tahmidyounus/Smart_Classroom/hardware/UPS_system.jpg

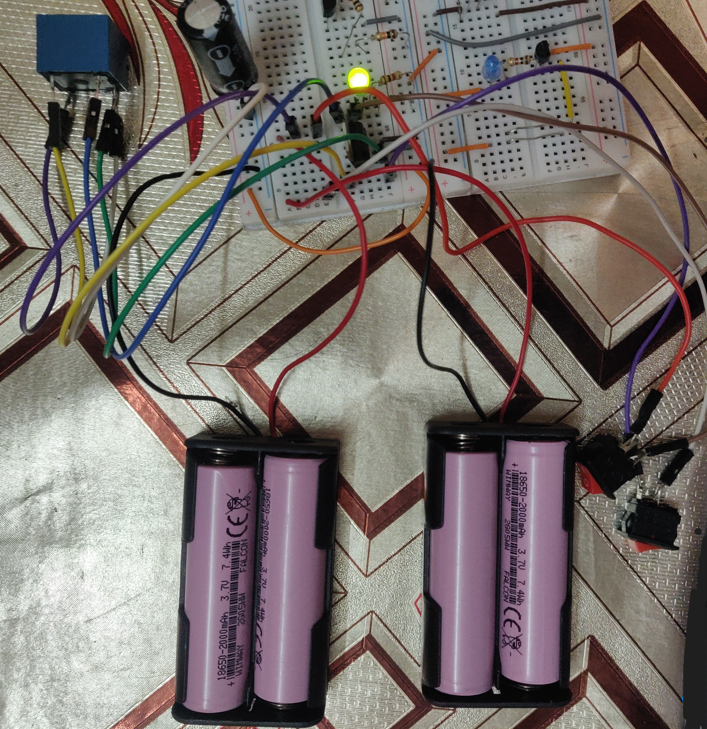
hardware/UPS_system.jpg
