tahmidyounus/Smart_Classroom/hardware/Seats.png

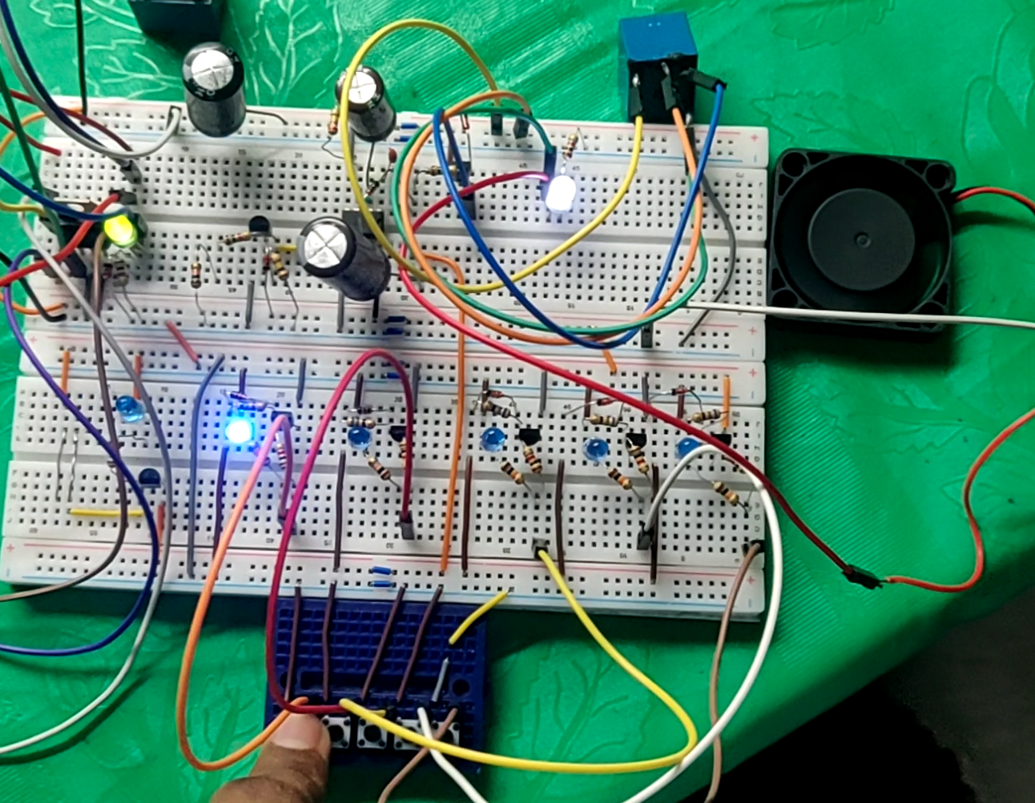
hardware/Seats.png
