tahmidyounus/Smart_Classroom/hardware/Comlete_design.png

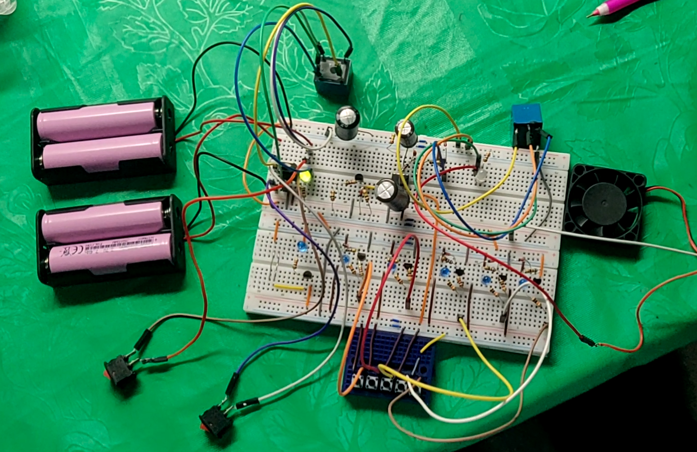
hardware/Comlete_design.png
