tahmidyounus/Smart_Classroom/schematics/Fire_alarm_off.png

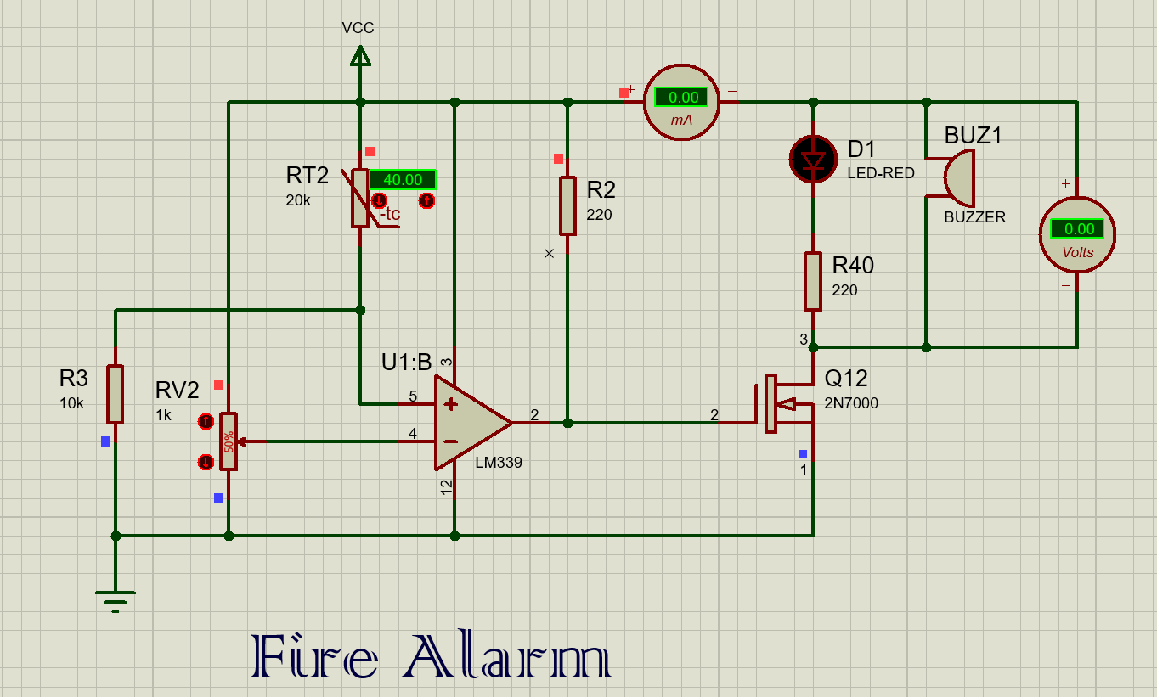
schematics/Fire_alarm_off.png
