tahmidyounus/Smart_Classroom/schematics/Fire_alarm_on.png

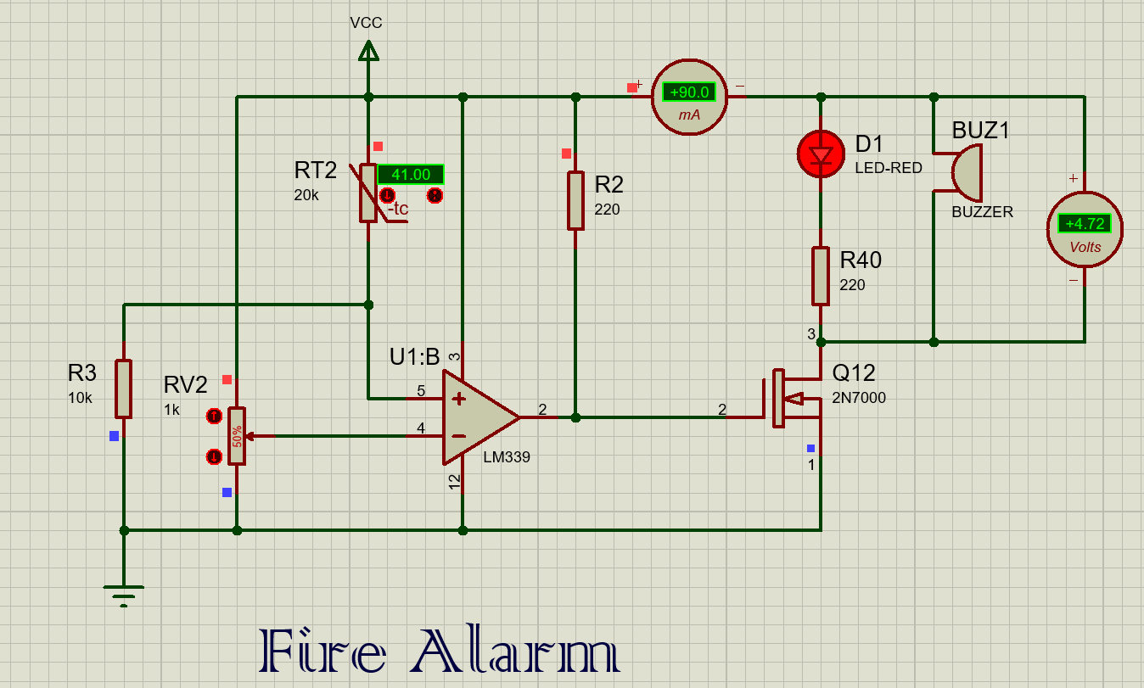
schematics/Fire_alarm_on.png
