tahmidyounus/Smart_Classroom/schematics/output_module.png

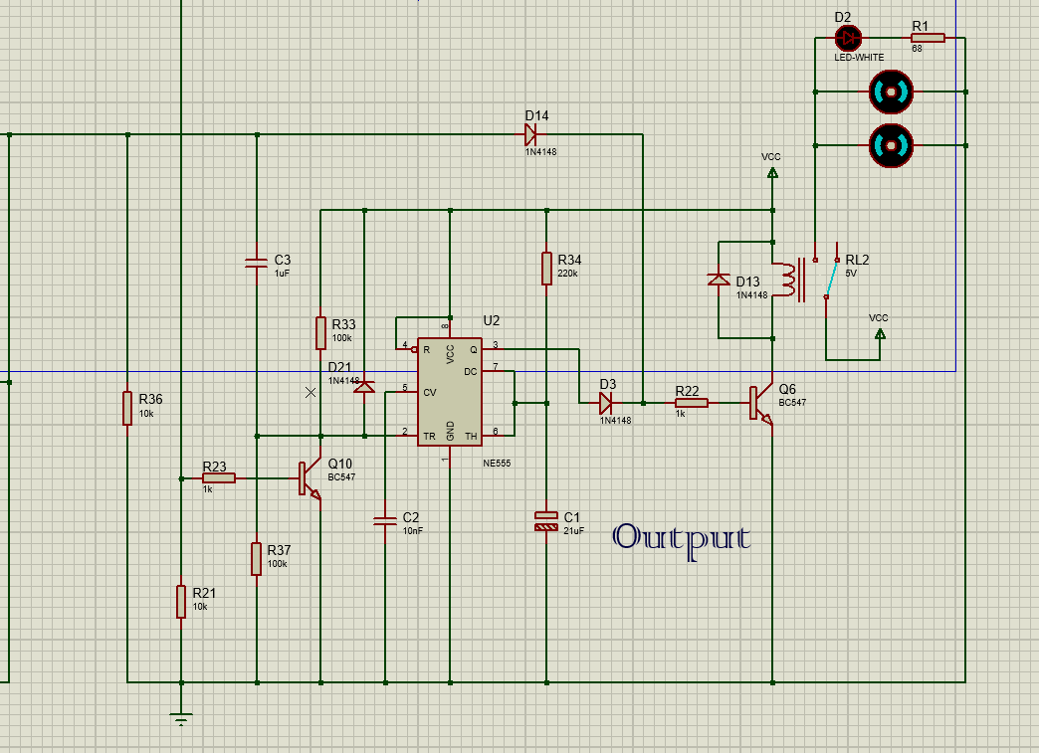
schematics/output_module.png
