tahmidyounus/Smart_Classroom/schematics/Single_seat_turned_on.png

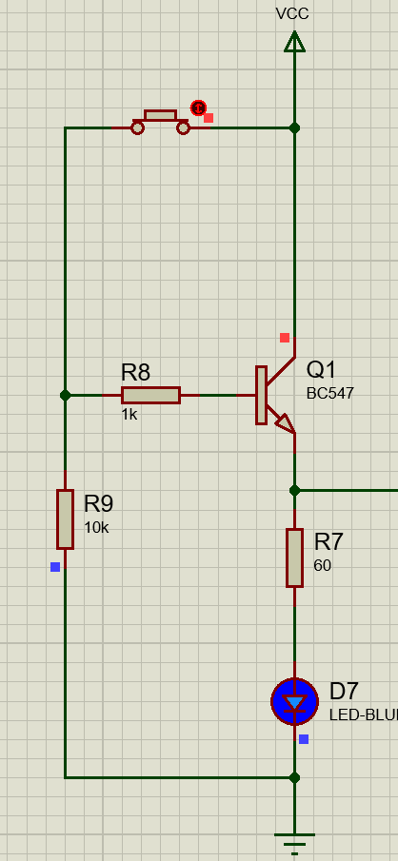
schematics/Single_seat_turned_on.png
