tahmidyounus/Smart_Classroom/schematics/Six_seat_module.png

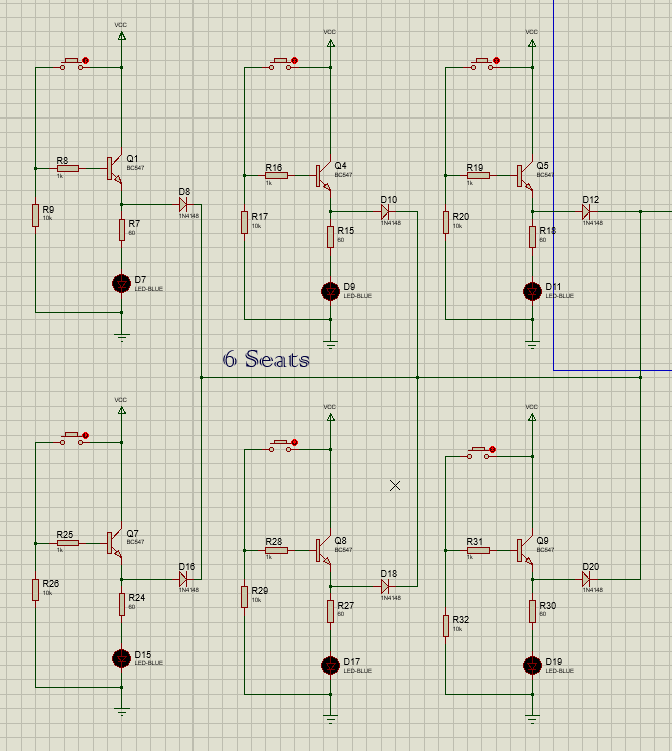
schematics/Six_seat_module.png
