tahmidyounus/Smart_Classroom/schematics/Touch_override_module.png

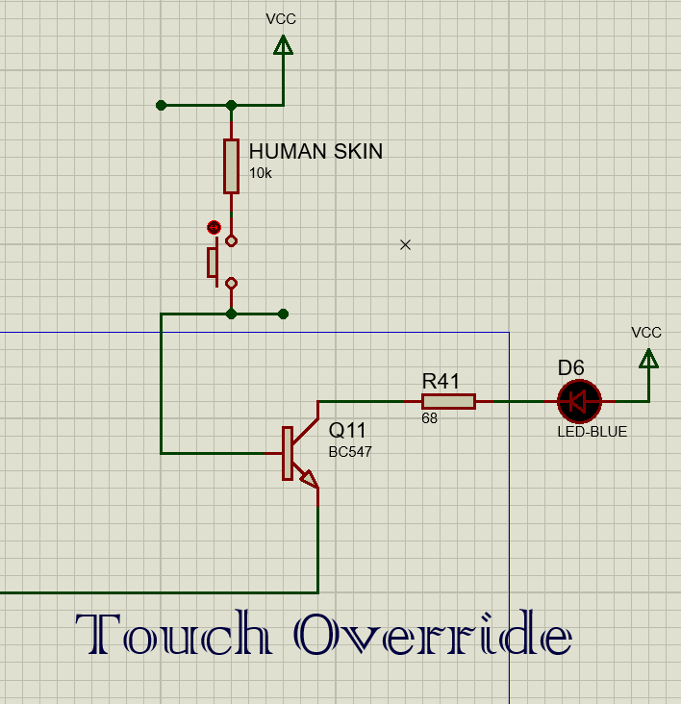
schematics/Touch_override_module.png
