tahmidyounus/Smart_Classroom/schematics/UPS_module.png

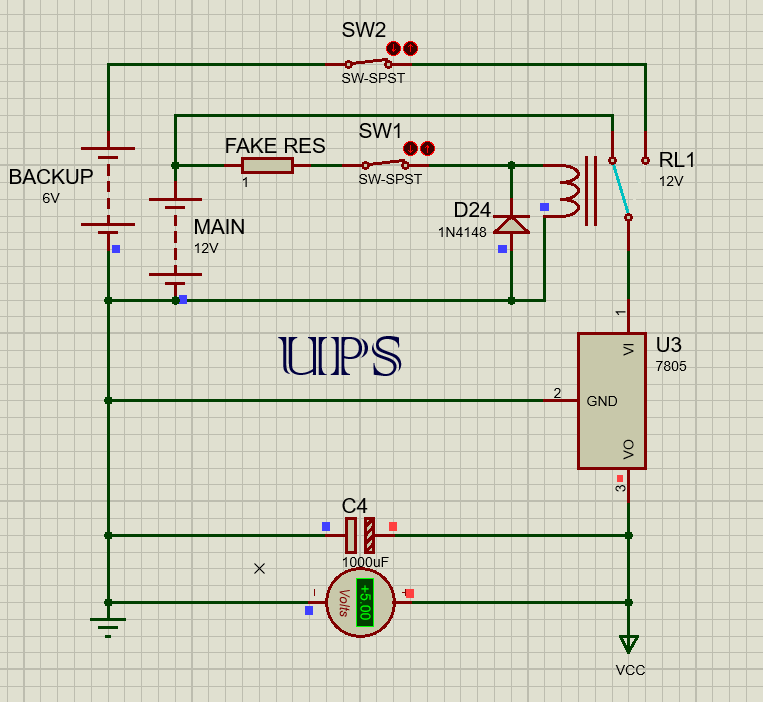
schematics/UPS_module.png
