tahmidyounus/Smart_Classroom/(list of files, drawings)

Other design files:
Smart_Classroom.pdsprj
